ke4pjw/Blitzen24/SDCARD/loading.gif

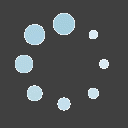
SDCARD/loading.gif
