ke4pjw/Blitzen24/SDCARD/P2.jpg

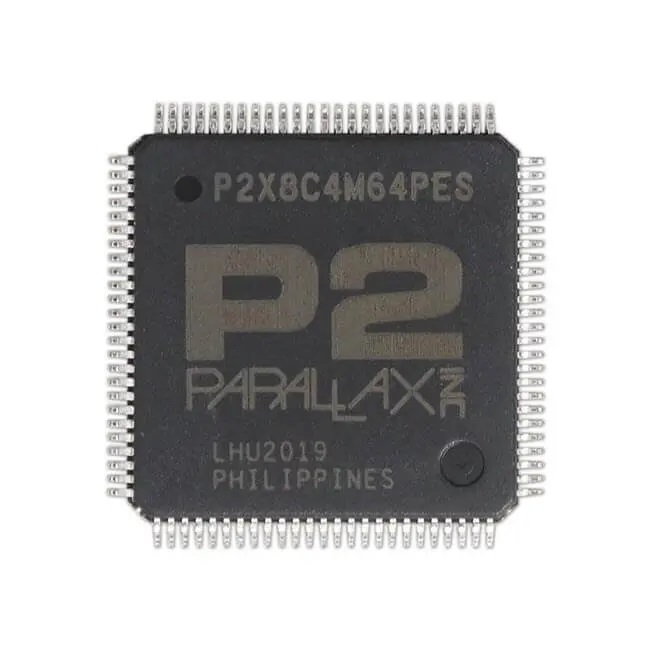
SDCARD/P2.jpg
