ke4pjw/Blitzen24/Hardware/Blitzen24v2.csv

Id | Designator | Footprint | Quantity | Designation | Supplier and ref
1 | J4,J3,J22,J19,J5,J20,J2,J1,J16,J13,J9,J10,J11,J6,J17,J21,J15,J7,J14,J12,J8,J18,J24,J23 | PhoenixContact_MSTBVA_2,5_3-G-5,08_1x03_P5.08mm_Vertical | 24 | Conn_01x03_Male
2 | F3,F14,F7,F9,F12,F4,F15,F22,F17,F2,F11,F1,F10,F20,F21,F5,F8,F6,F24,F23,F16,F13,F18,F19 | Fuseholder_Blade_Mini_Keystone_3568 | 24 | Fuse
3 | RN21-24,RN13-16,RN17-20,RN9-12,RN1-4,RN5-8 | R_Array_SIP8 | 6 | 4608X-102-101LF
4 | IC1 | DIP794W53P254L1930H508Q16N | 1 | SN75172N
5 | RN-DMX1 | 4608X102121LF | 1 | 4608X-102-121LF
6 | D1 | D_DO-41_SOD81_P10.16mm_Horizontal | 1 | 1N4001
7 | IC3,IC2,IC4 | DIP254P762X508-20 | 3 | SN74ACT241N
8 | VR1 | MCP18265002EAT | 1 | MIC29151-5.0WT
9 | J1000 | P2-edge-connector | 1 | P2_edge_connector
10 | J27 | 55564161 | 1 | 5556416-1
11 | PWR1,PWR2,PWR3 | TerminalBlock_Dinkle_DT-55-B01X-02_P10.00mm | 3 | Screw_Terminal_01x02
12 | C4,C1,C2,C3 | C320C104K5R5TA | 4 | C320C104K5R5TA
13 | RN6 | 4604X101103LF | 1 | 4604X-101-103LF
14 | WIZ610MJ2 | DIP-WIZ610MJ | 1 | WIZ610MJ
15 | SW1 | SW_PUSH_6mm | 1 | SW_Push
16 | J26 | PinHeader_1x04_P2.54mm_Vertical | 1 | Programming
17 | C5 | CAPPRD150W45D400H850 | 1 | ESS106M025AB2AA
18 | J25 | SSD1331 | 1 | SSD1331
19 | R1 | R_Axial_DIN0204_L3.6mm_D1.6mm_P2.54mm_Vertical | 1 | 100K
20 | RE1 | PEC11L4015FS0020 | 1 | MIC29151-5.0WT
