ke4pjw/Blitzen24/Hardware/Blitzen24v2.kicad_pcb

## KiCad design Hardware/Blitzen24v2.kicad_pcb (2026-04-16)

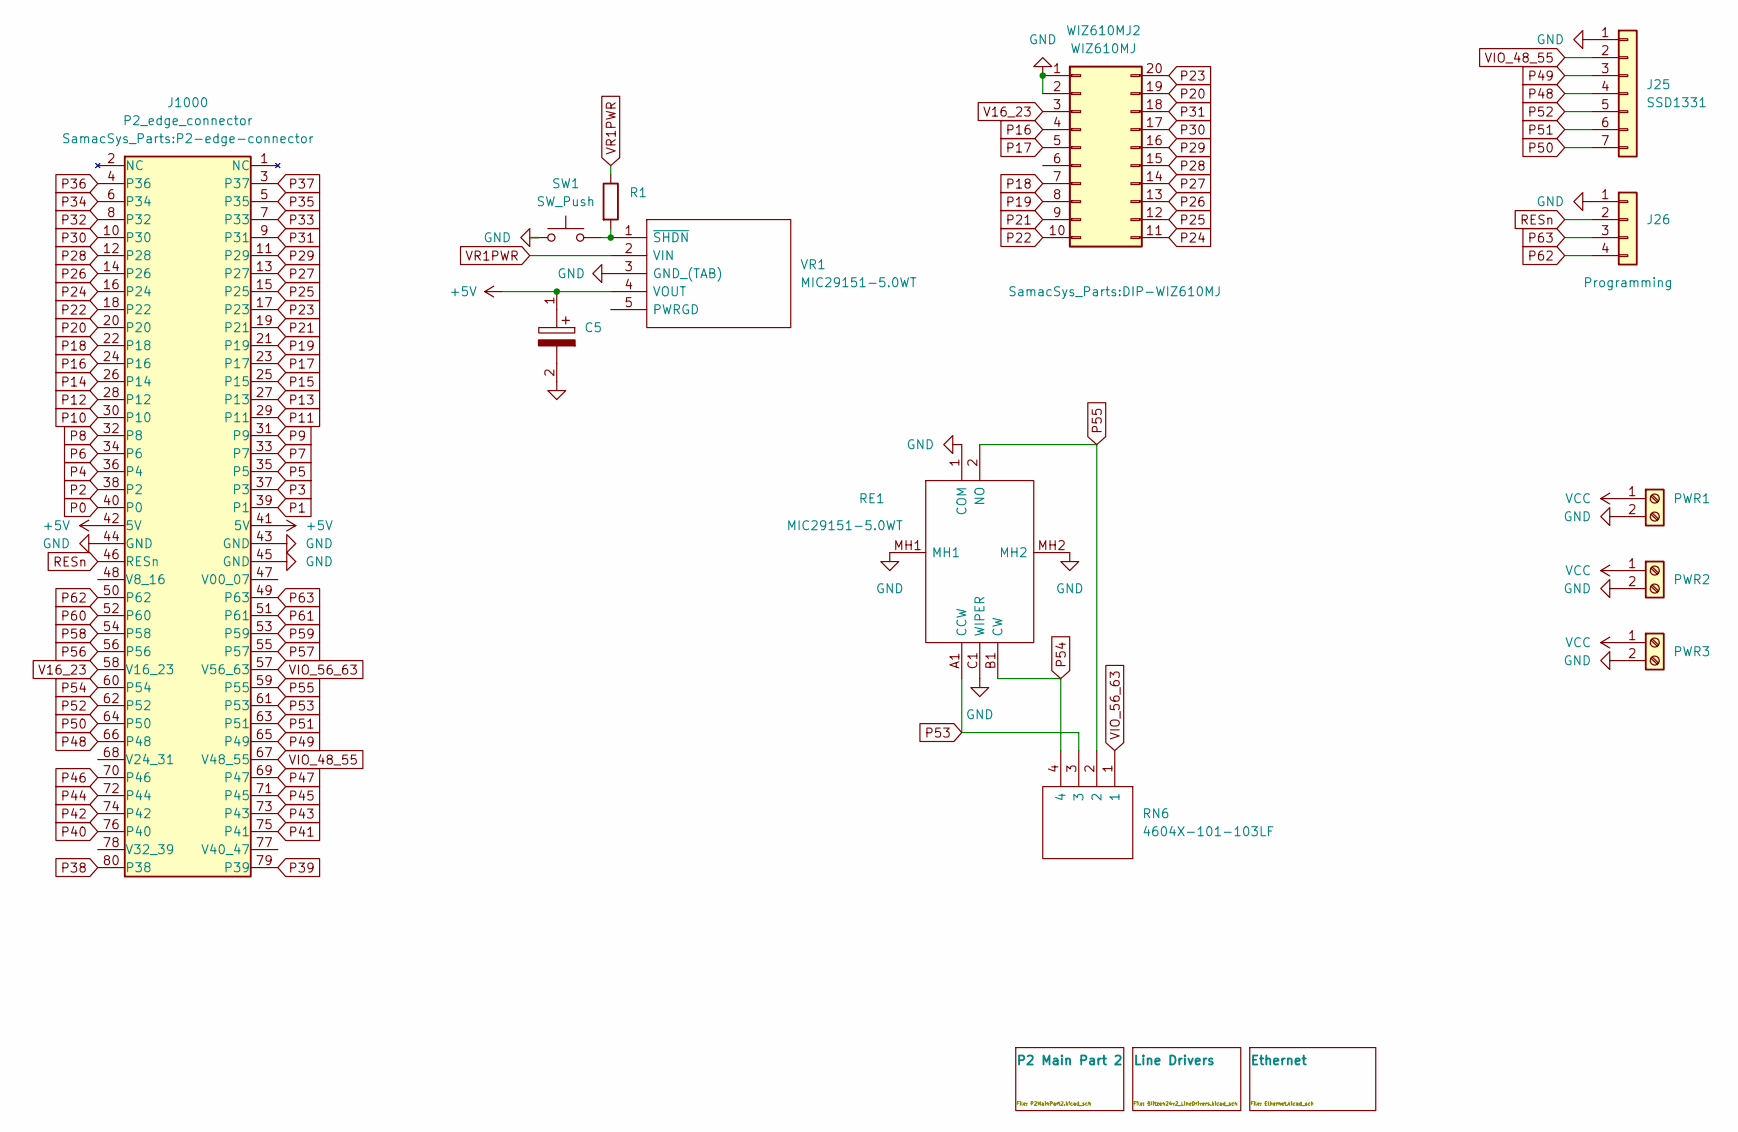
[picture p3: schematic Blitzen24v2.kicad_sch, Blitzen 24 Edge V2]

Parts:
C5: Mouser Part Number 80-ESS106M025AB2AA
J25: SSD1331
J26: Programming; PinHeader_1x04_P2.54mm_Vertical
J1000: P2_edge_connector; P2-edge-connector
PWR1, PWR2, PWR3: Screw_Terminal_01x02; TerminalBlock_Dinkle_DT-55-B01X-02_P10.00mm
R1: (no value)
RE1: MIC29151-5.0WT; PEC11L4015FS0020; Mouser Part Number 652-PEC11L4015FS0020
RN6: 4604X-101-103LF; 4604X101103LF; Mouser Part Number 652-4604X-1LF-10K
SW1: SW_Push
VR1: MIC29151-5.0WT; Mouser Part Number MIC29151-5.0WT
WIZ610MJ2: WIZ610MJ; DIP-WIZ610MJ

Connections:
+5V: C5.1, J1000.41 (5V), J1000.42 (5V), VR1.4 (VOUT); also elsewhere on the board
unnamed: R1.2, SW1.2, VR1.1 (~SHDN)
P0: J1000.40 (P0); also elsewhere on the board
P1: J1000.39 (P1); also elsewhere on the board
P2: J1000.38 (P2); also elsewhere on the board
P3: J1000.37 (P3); also elsewhere on the board
P4: J1000.36 (P4); also elsewhere on the board
P5: J1000.35 (P5); also elsewhere on the board
P6: J1000.34 (P6); also elsewhere on the board
P7: J1000.33 (P7); also elsewhere on the board
P8: J1000.32 (P8); also elsewhere on the board
P9: J1000.31 (P9); also elsewhere on the board
P10: J1000.30 (P10); also elsewhere on the board
P11: J1000.29 (P11); also elsewhere on the board
P12: J1000.28 (P12); also elsewhere on the board
P13: J1000.27 (P13); also elsewhere on the board
P14: J1000.26 (P14); also elsewhere on the board
P15: J1000.25 (P15); also elsewhere on the board
P16: J1000.24 (P16), WIZ610MJ2.4
P17: J1000.23 (P17), WIZ610MJ2.5
P18: J1000.22 (P18), WIZ610MJ2.7
P19: J1000.21 (P19), WIZ610MJ2.8
P20: J1000.20, WIZ610MJ2.19
P21: J1000.19 (P21), WIZ610MJ2.9
P22: J1000.18 (P22), WIZ610MJ2.10
P23: J1000.17 (P23), WIZ610MJ2.20
P24: J1000.16 (P24), WIZ610MJ2.11
P25: J1000.15 (P25), WIZ610MJ2.12
P26: J1000.14 (P26), WIZ610MJ2.13
P27: J1000.13 (P27), WIZ610MJ2.14
P28: J1000.12 (P28), WIZ610MJ2.15
P29: J1000.11 (P29), WIZ610MJ2.16
P30: J1000.10 (P30), WIZ610MJ2.17
P31: J1000.9 (P31), WIZ610MJ2.18
P32: J1000.8 (P32); also elsewhere on the board
P33: J1000.7 (P33); also elsewhere on the board
P34: J1000.6 (P34); also elsewhere on the board
P35: J1000.5 (P35); also elsewhere on the board
P36: J1000.4 (P36); also elsewhere on the board
P37: J1000.3 (P37); also elsewhere on the board
P38: J1000.80 (P38); also elsewhere on the board
P39: J1000.79 (P39); also elsewhere on the board
P40: J1000.76 (P40)
P41: J1000.75 (P41)
P42: J1000.74 (P42)
P43: J1000.73 (P43)
P44: J1000.72 (P44); also elsewhere on the board
P45: J1000.71 (P45); also elsewhere on the board
P46: J1000.70 (P46); also elsewhere on the board
P47: J1000.69 (P47); also elsewhere on the board
P48: J25.4, J1000.66 (P48)
P49: J25.3, J1000.65 (P49)
P50: J25.7, J1000.64 (P50)
P51: J25.6, J1000.63 (P51)
P52: J25.5, J1000.62 (P52)
P53: J1000.61 (P53), RE1.A1 (CCW), RN6.3
P54: J1000.60 (P54), RE1.B1 (CW), RN6.4
P55: J1000.59 (P55), RE1.2 (NO), RN6.2
P56: J1000.56
P57: J1000.55 (P57)
P58: J1000.54 (P58)
P59: J1000.53 (P59)
P60: J1000.52 (P60)
P61: J1000.51 (P61)
P62: J26.4, J1000.50 (P62)
P63: J26.3, J1000.49 (P63)
RESn: J26.2, J1000.46 (RESn)
V16_23: J1000.58 (V16_23), WIZ610MJ2.3
VCC: PWR1.1, PWR2.1, PWR3.1; also elsewhere on the board
VIO_48_55: J25.2, J1000.67 (V48_55)
VIO_56_63: J1000.57 (V56_63), RN6.1
VR1PWR: R1.1, VR1.2 (VIN); also elsewhere on the board

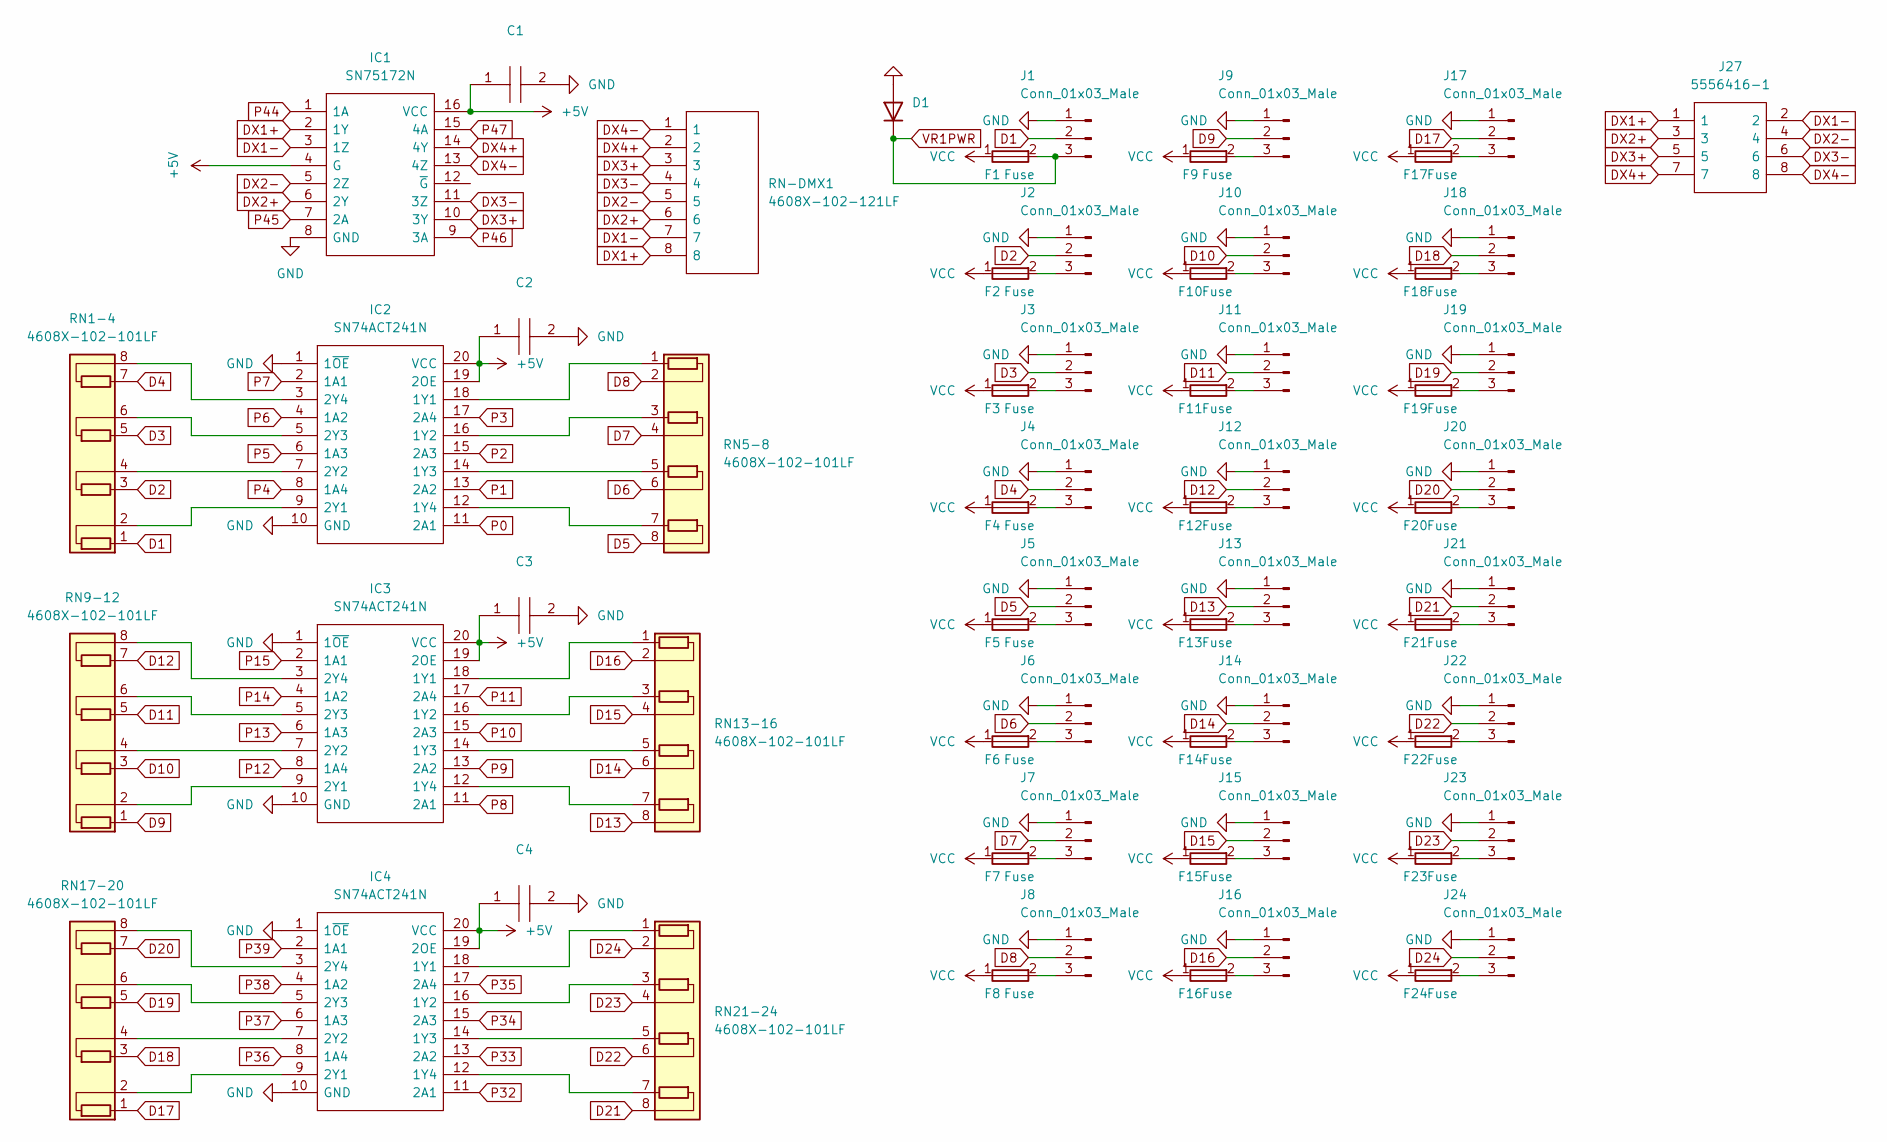
[picture p4: schematic Blitzen24v2_LineDrivers.kicad_sch, Blitzen 24 Edge V2]

Parts:
C1, C2, C3, C4: Mouser Part Number 80-C320C104K5R
D1: (no value)
F1, F2, F3, F4, F5, F6, F7, F8, F9, F10, F11, F12, F13, F14, F15, F16, F17, F18, F19, F20, F21, F22, F23, F24: Fuse; Fuseholder_Blade_Mini_Keystone_3568
IC1: SN75172N; DIP794W53P254L1930H508Q16N; Mouser Part Number 595-SN75172N
IC2, IC3, IC4: SN74ACT241N; DIP254P762X508-20; Mouser Part Number 595-SN74ACT241N
J1, J2, J3, J4, J5, J6, J7, J8, J9, J10, J11, J12, J13, J14, J15, J16, J17, J18, J19, J20, J21, J22, J23, J24: Conn_01x03_Male; PhoenixContact_MSTBVA_2,5_3-G-5,08_1x03_P5.08mm_Vertical
J27: 5556416-1; 55564161; Mouser Part Number 571-5556416-1
RN1-4, RN5-8, RN9-12, RN13-16, RN17-20, RN21-24: 4608X-102-101LF; R_Array_SIP8
RN-DMX1: 4608X-102-121LF; 4608X102121LF; Mouser Part Number 652-4608X-2LF-120

Connections:
+5V: C1.1, C2.1, C3.1, C4.1, IC1.4 (G), IC1.16 (VCC), IC2.19 (2OE), IC2.20 (VCC), IC3.19 (2OE), IC3.20 (VCC), IC4.19 (2OE), IC4.20 (VCC); also elsewhere on the board
D1: J1.2, RN1-4.1 (R1.1)
D2: J2.2, RN1-4.3 (R2.1)
D3: J3.2, RN1-4.5 (R3.1)
D4: J4.2, RN1-4.7 (R4.1)
D5: J5.2, RN5-8.8 (R4.2)
D6: J6.2, RN5-8.6 (R3.2)
D7: J7.2, RN5-8.4 (R2.2)
D8: J8.2, RN5-8.2 (R1.2)
D9: J9.2, RN9-12.1 (R1.1)
D10: J10.2, RN9-12.3 (R2.1)
D11: J11.2, RN9-12.5 (R3.1)
D12: J12.2, RN9-12.7 (R4.1)
D13: J13.2, RN13-16.8 (R4.2)
D14: J14.2, RN13-16.6 (R3.2)
D15: J15.2, RN13-16.4 (R2.2)
D16: J16.2, RN13-16.2 (R1.2)
D17: J17.2, RN17-20.1 (R1.1)
D18: J18.2, RN17-20.3 (R2.1)
D19: J19.2, RN17-20.5 (R3.1)
D20: J20.2, RN17-20.7 (R4.1)
D21: J21.2, RN21-24.8 (R4.2)
D22: J22.2, RN21-24.6 (R3.2)
D23: J23.2, RN21-24.4 (R2.2)
D24: J24.2, RN21-24.2 (R1.2)
DX1+: IC1.2 (1Y), J27.1, RN-DMX1.8
DX1-: IC1.3 (1Z), J27.2, RN-DMX1.7
DX2+: IC1.6 (2Y), J27.3, RN-DMX1.6
DX2-: IC1.5 (2Z), J27.4, RN-DMX1.5
DX3+: IC1.10 (3Y), J27.5, RN-DMX1.3
DX3-: IC1.11 (3Z), J27.6, RN-DMX1.4
DX4+: IC1.14 (4Y), J27.7, RN-DMX1.2
DX4-: IC1.13 (4Z), J27.8, RN-DMX1.1
unnamed: F2.2, J2.3
unnamed: F3.2, J3.3
unnamed: F4.2, J4.3
unnamed: F5.2, J5.3
unnamed: F6.2, J6.3
unnamed: F7.2, J7.3
unnamed: F8.2, J8.3
unnamed: F9.2, J9.3
unnamed: F10.2, J10.3
unnamed: F11.2, J11.3
unnamed: F12.2, J12.3
unnamed: F13.2, J13.3
unnamed: F14.2, J14.3
unnamed: F15.2, J15.3
unnamed: F16.2, J16.3
unnamed: F17.2, J17.3
unnamed: F18.2, J18.3
unnamed: F19.2, J19.3
unnamed: F20.2, J20.3
unnamed: F21.2, J21.3
unnamed: F22.2, J22.3
unnamed: F23.2, J23.3
unnamed: F24.2, J24.3
unnamed: IC2.3 (2Y4), RN1-4.8 (R4.2)
unnamed: IC2.5 (2Y3), RN1-4.6 (R3.2)
unnamed: IC2.7 (2Y2), RN1-4.4 (R2.2)
unnamed: IC2.9 (2Y1), RN1-4.2 (R1.2)
unnamed: IC2.12 (1Y4), RN5-8.7 (R4.1)
unnamed: IC2.14 (1Y3), RN5-8.5 (R3.1)
unnamed: IC2.16 (1Y2), RN5-8.3 (R2.1)
unnamed: IC2.18 (1Y1), RN5-8.1 (R1.1)
unnamed: IC3.3 (2Y4), RN9-12.8 (R4.2)
unnamed: IC3.5 (2Y3), RN9-12.6 (R3.2)
unnamed: IC3.7 (2Y2), RN9-12.4 (R2.2)
unnamed: IC3.9 (2Y1), RN9-12.2 (R1.2)
unnamed: IC3.12 (1Y4), RN13-16.7 (R4.1)
unnamed: IC3.14 (1Y3), RN13-16.5 (R3.1)
unnamed: IC3.16 (1Y2), RN13-16.3 (R2.1)
unnamed: IC3.18 (1Y1), RN13-16.1 (R1.1)
unnamed: IC4.3 (2Y4), RN17-20.8 (R4.2)
unnamed: IC4.5 (2Y3), RN17-20.6 (R3.2)
unnamed: IC4.7 (2Y2), RN17-20.4 (R2.2)
unnamed: IC4.9 (2Y1), RN17-20.2 (R1.2)
unnamed: IC4.12 (1Y4), RN21-24.7 (R4.1)
unnamed: IC4.14 (1Y3), RN21-24.5 (R3.1)
unnamed: IC4.16 (1Y2), RN21-24.3 (R2.1)
unnamed: IC4.18 (1Y1), RN21-24.1 (R1.1)
P0: IC2.11 (2A1); also elsewhere on the board
P1: IC2.13 (2A2); also elsewhere on the board
P2: IC2.15 (2A3); also elsewhere on the board
P3: IC2.17 (2A4); also elsewhere on the board
P4: IC2.8 (1A4); also elsewhere on the board
P5: IC2.6 (1A3); also elsewhere on the board
P6: IC2.4 (1A2); also elsewhere on the board
P7: IC2.2 (1A1); also elsewhere on the board
P8: IC3.11 (2A1); also elsewhere on the board
P9: IC3.13 (2A2); also elsewhere on the board
P10: IC3.15 (2A3); also elsewhere on the board
P11: IC3.17 (2A4); also elsewhere on the board
P12: IC3.8 (1A4); also elsewhere on the board
P13: IC3.6 (1A3); also elsewhere on the board
P14: IC3.4 (1A2); also elsewhere on the board
P15: IC3.2 (1A1); also elsewhere on the board
P32: IC4.11 (2A1); also elsewhere on the board
P33: IC4.13 (2A2); also elsewhere on the board
P34: IC4.15 (2A3); also elsewhere on the board
P35: IC4.17 (2A4); also elsewhere on the board
P36: IC4.8 (1A4); also elsewhere on the board
P37: IC4.6 (1A3); also elsewhere on the board
P38: IC4.4 (1A2); also elsewhere on the board
P39: IC4.2 (1A1); also elsewhere on the board
P44: IC1.1 (1A); also elsewhere on the board
P45: IC1.7 (2A); also elsewhere on the board
P46: IC1.9 (3A); also elsewhere on the board
P47: IC1.15 (4A); also elsewhere on the board
VCC: F1.1, F2.1, F3.1, F4.1, F5.1, F6.1, F7.1, F8.1, F9.1, F10.1, F11.1, F12.1, F13.1, F14.1, F15.1, F16.1, F17.1, F18.1, F19.1, F20.1, F21.1, F22.1, F23.1, F24.1; also elsewhere on the board
VR1PWR: D1.1 (K), F1.2, J1.3; also elsewhere on the board

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
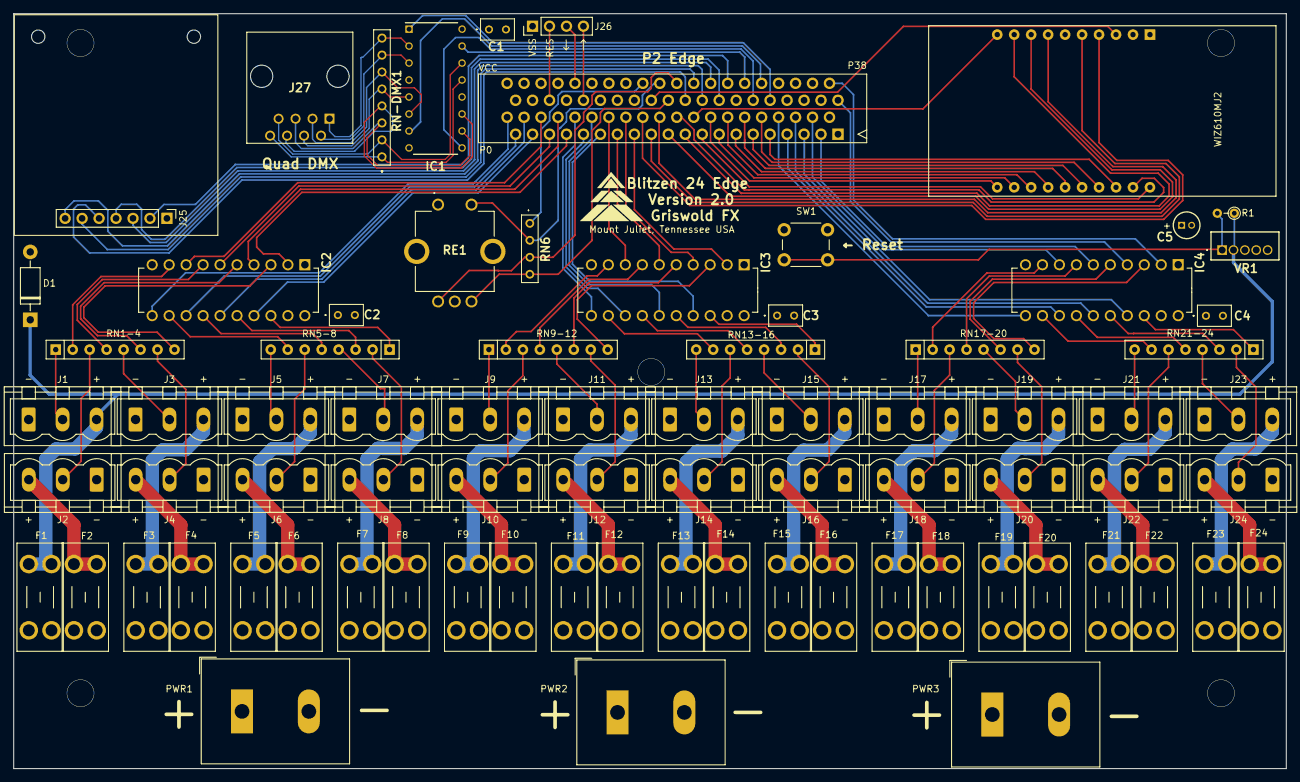
[picture p5: board Blitzen24v2.kicad_pcb from above]

Board: 4 copper layers, 190.5 x 113.0 mm, 78 parts (0 on the bottom side), 142 nets.
