ke4pjw/Blitzen24/(commit log)

2022-03-03 Updated 2 files under /
    Multi Universes per pin works
2022-03-07 Corrected bug with E1.31 array. Added W6100 interrupt for socket 3. Fixed bug where socket was not being cleared correctly.
2022-03-15 Fixed bug in pin output configuration for 2nd ws2812 output. Added outputs in config for more E1.31 universes.
2022-03-31 Updated 2 files under /
    Updated comments to reflect this is not Jon's driver and changed filename per Jon's request.
2022-04-06 Updated 2 files under / SD card driver, webserver, and resource locking added.
2022-04-12 Updated 8 files under /SDCARD A website is born.
    [BLITZEN.CFG]
2022-04-19 Updated 2 files under / Added restart of pixel driver and E131 receiver cogs when E131 config updated.
2022-04-27 Updated 3 files under / Added individual RBGswaps in the pixel driver.
    Minor change in W6100 driver.
2022-04-28 Deleted BLITZEN.CFG
    Config Memory Changed
    [BLITZEN.CFG]
2022-08-05 Updated 2 files under /Hardware
    [Blitzen_23_Edge.sch]
2022-08-09 Prototype Board Order
    [Blitzen_23_Edge.sch]
2022-08-25 Migrated to a cog-less SD card driver. Thank you Rayman!
2022-08-26 Added EP00026917.zip to /Hardware
    Gerber Files
2022-10-20 Updated 2 files under / Added Brightness to the pixel driver
2022-12-11 Updated 3 files under / Updated W6100 driver so that all cogs drive WRn,RDn,A0,A1, and CS all the time. This required the signals to be inverted.
    Reduced drive to pins 5 - 8 in pixel driver.
    Solved 99% of glitching.
2022-12-20 Added Blitzen24.spin2 to / Previous Versions would set pixel string length based on the first pin of the pingroup. Now pixel string length for the pingroup is based on the highest pixel count in the 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
2023-01-02 Updated W6100drv.spin2
    Found the video driver referenced in here and removed it.
2023-02-02 Additional duplicate universe checking added to the current output that is being updated.
2024-09-21 Updated 5 files under / This is the V2.0 Board files
2024-09-21 Updated 2 files under / Fixed quadrature Encoder. Added pushbutton wakeup. Added version menu.
2025-02-15 Added MemoryStructure.md Keeping track of this structure to add long range boards. Unfortunately I did not allow enough ports in the PIXELCONFIG structure. I need to decide if I want to lose compatib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
2026-04-16 Deleted Blitzen_23_Edge.sch
    [Blitzen_23_Edge.sch]
2026-04-16 Added 12 files to /Hardware
    [Blitzen24v2.csv, Blitzen24v2.kicad_pcb, Blitzen24v2.kicad_sch, Blitzen24v2_LineDrivers.kicad_sch, Ethernet.kicad_sch, P2MainPart2.kicad_sch]
2026-11-11 DDP input, selectable with E1.31: W6100drv 1.8, Blitzen 24 2.6.1 Dev, SD card pages
    - DDP (UDP 4048) as an alternative input to E1.31, with its own saved table (PROTOCOL + DDPCONFIG appended to the config block)
    - Fast-RX cog DDP decode through a LUT map; Socket 3 RX buffer 4K, Sockets 0 and 7 1K, others 2K
    - DMX outputs always 510 channels in DDP mode
    - New SDCARD/ddp.htm; e131.htm protocol selector; dmx.htm DDP start channels; nav label "Input Settings"
    Related to #63 (QA pending).
2026-11-12 Unsaved-changes banner and upgrade block (#64)
    - CRC-32 (GETCRC) of the config block, baseline after boot (config applied, DHCP done) and after each complete save in writeconfig(); RAM only, config file layout unchanged.
    - Checked after every POST: a no-op save or an undone change does not count.
    - Banner with a Save link appended to every page's firmware-generated script; upgrade links on Configs replaced with a save-first note.
    - upgrade.js and upgraderun.js refuse to start while unsaved; reboot.js warns (Save first / Reboot anyway) instead of rebooting.
    - reboot.htm keeps the redirect timer id so the warning can cancel it.
2026-11-12 OLED Network screen; Version screen no longer scrolls (#72)
    - Version screen: build string and uptime only (Speed/Dpx pushed it past 8 rows, so it scrolled).
    - New Network screen after Version: hostname (without .local; 17-31 characters wrap to a second row), IP, MAC, Speed/Duplex, each on a fixed row.
    - Pixel Test moves to screen 5; screen numbers are now constants (PG_NETWORK, PG_PIXELTEST, PG_LAST).
    - Pixel Test screen redraws only after input: the redraw check moved out of the case line, where ptdraw() ran every second and flickered (also in the #42 build).
2026-11-12 Pixel tests keep running when the OLED display sleeps (#74)
    - Display sleep on the Pixel Test screen no longer stops all tests; the display keeps its image and waking with the button shows the same list.
    - Turning to another screen, All off and the 1.5 s hold still stop all tests.
    - Changes Feature 42 acceptance criterion 6.
2026-11-13 Feature 73: Rainbow pixel test; pixel tests drawn by their own cog (2.6.6 Dev)
    - New pixeltest.spin2: test cog started in the fast-RX cog's place while tests run.
    Draws Red/Green/Blue/White blink (1 s on / 1 s off) and Rainbow (color wheel
    moving along each output from its pixel 1), only on outputs under test.
    - Watchdog: blink code removed; alt now only blinks the OLED receive icon.
    - applytests() stops/starts the test cog; testhold()/testresume() wrap the output
    rebuild in reloadoutputs(), setprotocol() and the E1.31 save. If no cog is free,
    tests are cleared and receive restarts (only if not already running).
    - OLED Pixel Test: Rainbow between White and Off, drawn one color per le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
2026-11-13 CHANGELOG.md: full history since the start of the project (#77)
    - Every release from Pre-Release 1 (2022) through 2.6.6, reconstructed from the code at
    each release branch, the work items and the commit messages.
    - 2.4.0 now leads with Stephen M. Moraco and Chris Gadd's micro_sd_fat32_fs SD/FAT32
    driver; new Credits section; open work items and deferred known issues.
2026-11-13 Update README for 2.6.6 (Rocklin) [#77]
    - Current release, features, links (ADO, GitHub mirror, binary zip, forum thread)
    - Repository layout table, known bugs (#67, #76) and to-do (#58, #68-70) linked to ADO
    - Build section now uses spinc -u -b; credits for the SD/FAT32 drivers
2026-11-14 Reset and release the SD card before every reboot [#78]
    - New sdrelease.spin2: clears the SD driver's leftover smart pin modes, sends CMD0 (up to 3 tries), then CS high + 16 clocks, then floats all four pins
    - rebootjs() calls it after sd.unmount()/sd.stop(), so some card brands no longer fail to boot after a firmware update or Reboot until power cycled
    - Debug-only lines in rebootjs() report unmount/stop status and the CMD0 reply (R1)
    - Version 2.6.7 (Rocklin) Dev
    - Bench-tested: affected card boots after Reboot and after an OTA update; two more cards boot after Reboot (R1 = $01 on all)
